eggsacc/FOCdrive/Kicad/FOC-driver.kicad_pcb

## KiCad design Kicad/FOC-driver.kicad_pcb (2026-07-19)

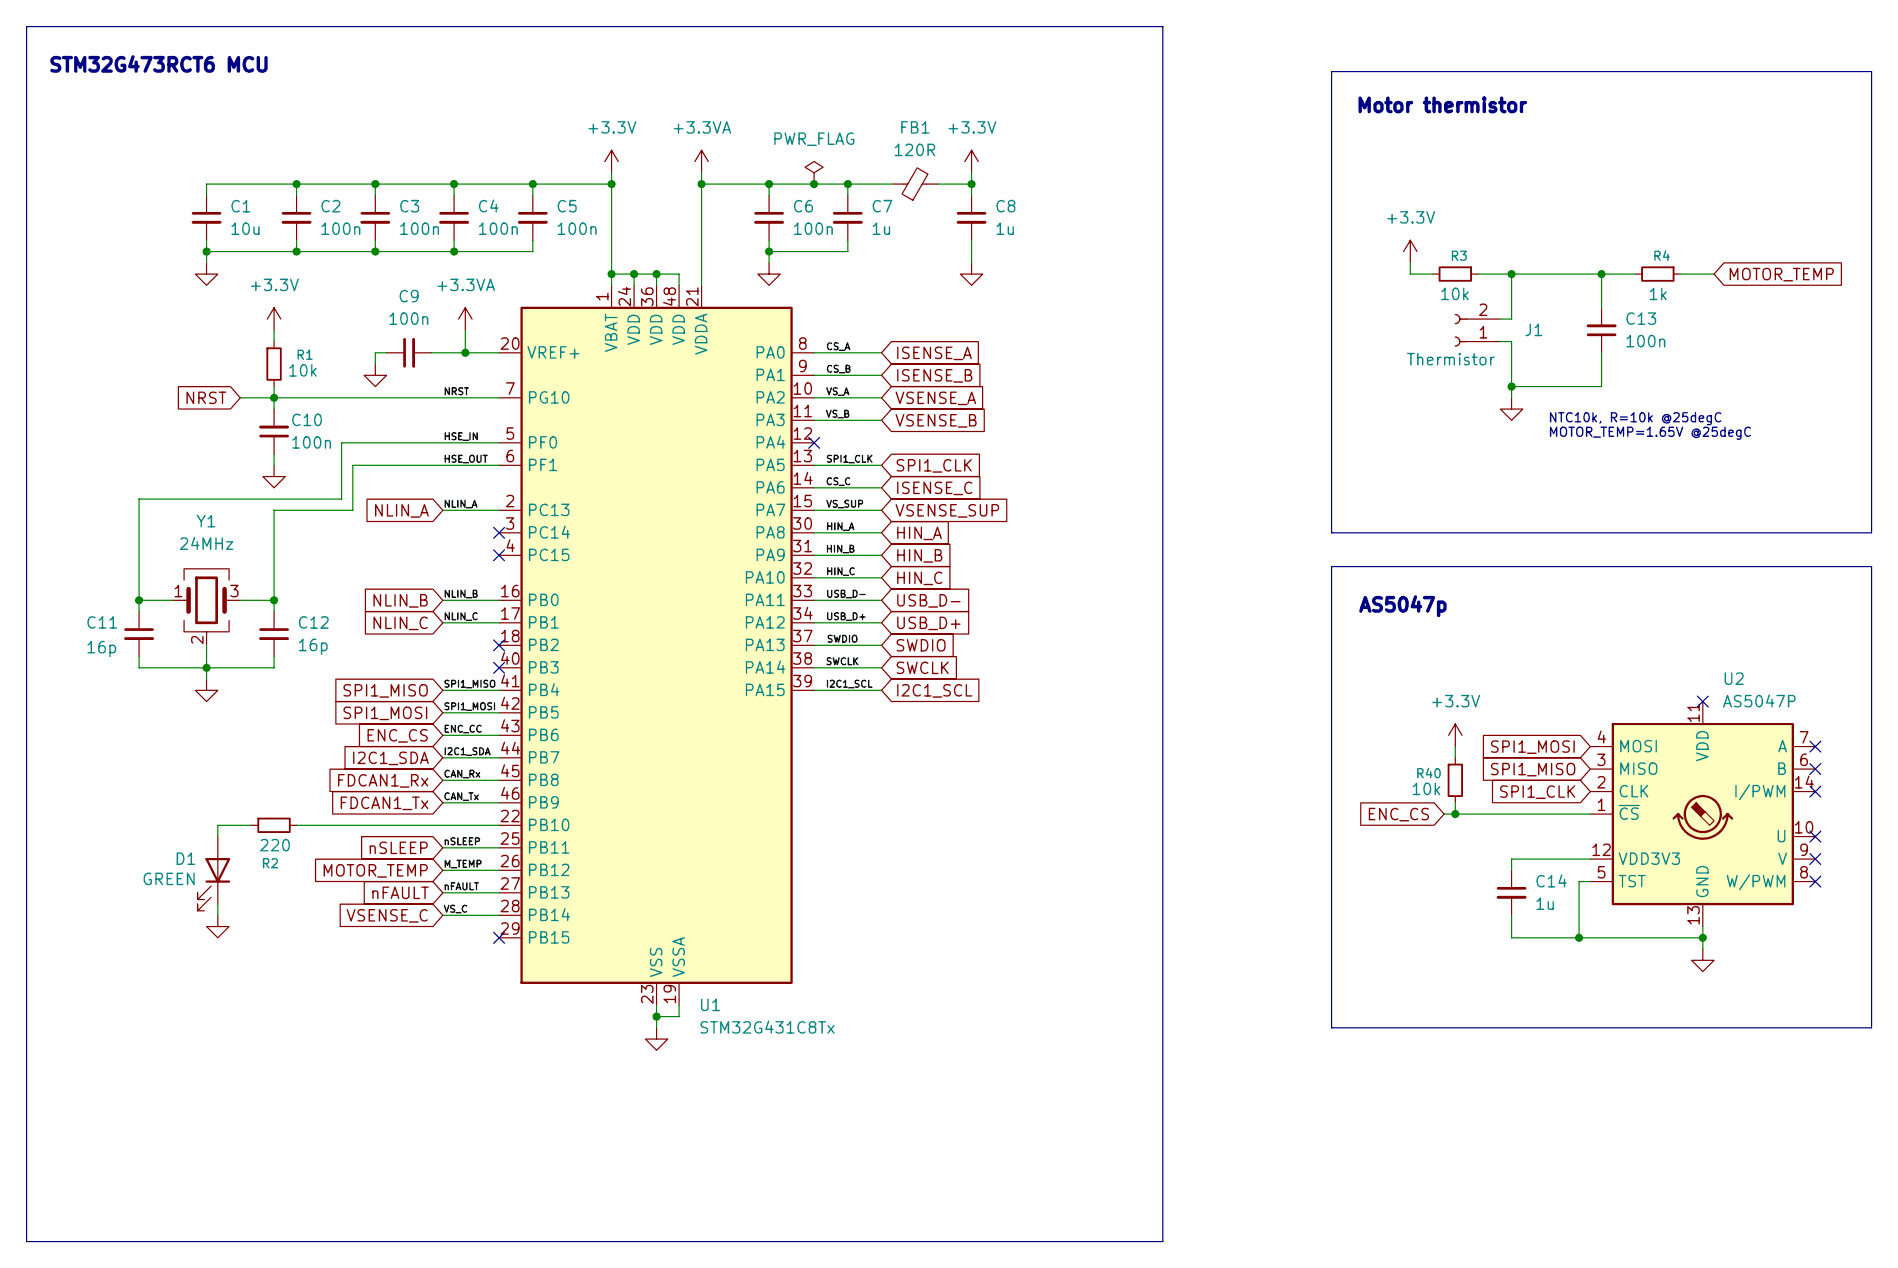
[picture p5: schematic untitled.kicad_sch]

Parts:
C1: 10u; C_1206_3216Metric
C2, C3, C4, C5, C6, C9, C13: 100n; C_0402_1005Metric
C7, C8, C14: 1u; C_0603_1608Metric
C10: 100n; C_01005_0402Metric
C11, C12: 16p; C_0402_1005Metric
D1: GREEN; LED_0603_1608Metric
FB1: 120R; L_0603_1608Metric
J1: Thermistor; 2p SolderWire Pad
R1, R3, R40: 10k; R_0402_1005Metric
R2: 220; R_0603_1608Metric
R4: 1k; R_0402_1005Metric
U1: STM32G431C8Tx; LQFP-48_7x7mm_P0.5mm
U2: AS5047P; TSSOP-14_4.4x5mm_P0.65mm
Y1: 24MHz; Crystal_SMD_3225-4Pin_3.2x2.5mm

Connections:
+3.3V: C1.1, C2.1, C3.1, C4.1, C5.1, C8.1, FB1.2, R1.1, R3.2, R40.1, U1.1 (VBAT), U1.24 (VDD), U1.36 (VDD), U1.48 (VDD); also elsewhere on the board
+3.3VA: C6.1, C7.1, C9.2, FB1.1, U1.20 (VREF+), U1.21 (VDDA); also elsewhere on the board
/mcu/HSE_IN: C11.1, U1.5 (PF0), Y1.1
/mcu/HSE_OUT: C12.1, U1.6 (PF1), Y1.3
ENC_CS: R40.2, U1.43 (PB6), U2.1 (~CS)
FDCAN1_Rx: U1.45 (PB8); also elsewhere on the board
FDCAN1_Tx: U1.46 (PB9); also elsewhere on the board
HIN_A: U1.30 (PA8); also elsewhere on the board
HIN_B: U1.31 (PA9); also elsewhere on the board
HIN_C: U1.32 (PA10); also elsewhere on the board
I2C1_SCL: U1.39 (PA15); also elsewhere on the board
I2C1_SDA: U1.44 (PB7); also elsewhere on the board
ISENSE_A: U1.8 (PA0); also elsewhere on the board
ISENSE_B: U1.9 (PA1); also elsewhere on the board
ISENSE_C: U1.14 (PA6); also elsewhere on the board
LSS: C1.2, C2.2, C3.2, C4.2, C5.2, C6.2, C7.2, C8.2, C9.1, C10.1, C11.2, C12.2, C13.1, C14.2, D1.1 (K), J1.1, U1.19 (VSSA), U1.23 (VSS), U1.35 (VSS), U1.47 (VSS), U2.5 (TST), U2.13 (GND), Y1.2 (G), Y1.4 (G); also elsewhere on the board
MOTOR_TEMP: R4.1, U1.26 (PB12)
NLIN_A: U1.2 (PC13); also elsewhere on the board
NLIN_B: U1.16 (PB0); also elsewhere on the board
NLIN_C: U1.17 (PB1); also elsewhere on the board
NRST: C10.2, R1.2, U1.7 (PG10); also elsewhere on the board
unnamed: D1.2 (A), R2.1
unnamed: C13.2, J1.2, R3.1, R4.2
unnamed: R2.2, U1.22 (PB10)
unnamed: C14.1, U2.12 (VDD3V3)
SPI1_CLK: U1.13 (PA5), U2.2 (CLK)
SPI1_MISO: U1.41 (PB4), U2.3 (MISO)
SPI1_MOSI: U1.42 (PB5), U2.4 (MOSI)
SWCLK: U1.38 (PA14); also elsewhere on the board
SWDIO: U1.37 (PA13); also elsewhere on the board
USB_D+: U1.34 (PA12); also elsewhere on the board
USB_D-: U1.33 (PA11); also elsewhere on the board
VSENSE_A: U1.10 (PA2); also elsewhere on the board
VSENSE_B: U1.11 (PA3); also elsewhere on the board
VSENSE_C: U1.28 (PB14); also elsewhere on the board
VSENSE_SUP: U1.15 (PA7); also elsewhere on the board
nFAULT: U1.27 (PB13); also elsewhere on the board
nSLEEP: U1.25 (PB11); also elsewhere on the board

Notes on the sheet:
AS5047p
STM32G473RCT6 MCU
NTC10k, R=10k @25degC MOTOR_TEMP=1.65V @25degC
Motor thermistor

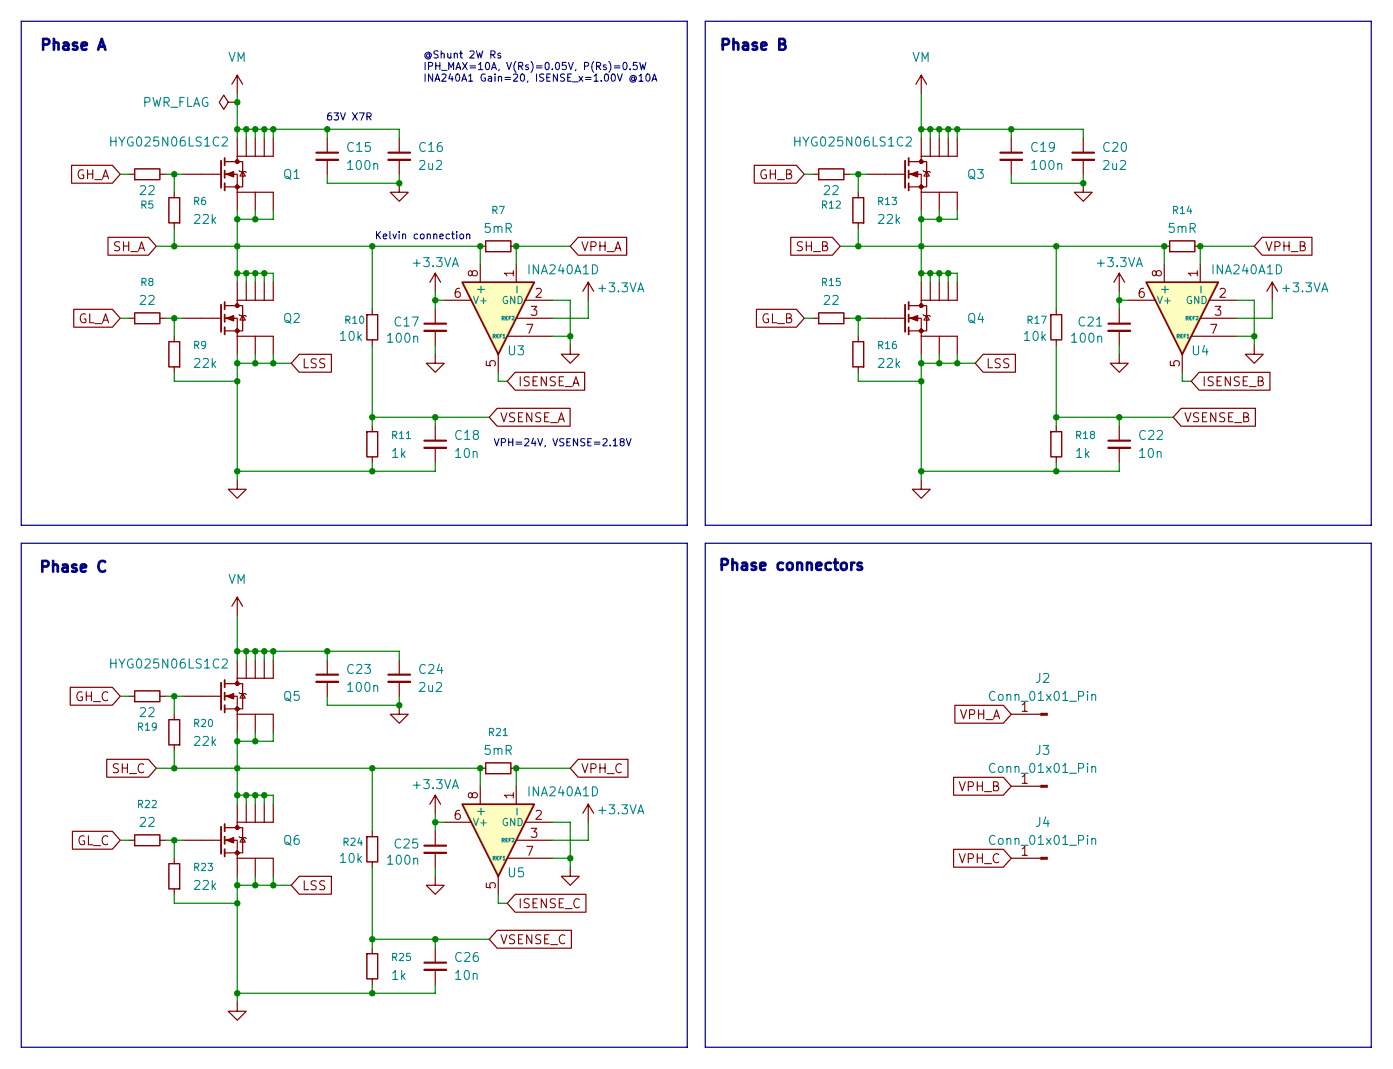
[picture p6: schematic half-bridges.kicad_sch]

Parts:
C15, C17, C19, C21, C23, C25: 100n; C_0603_1608Metric
C16, C20, C24: 2u2; C_1206_3216Metric
C18, C22, C26: 10n; C_0402_1005Metric
J2, J3, J4: Conn_01x01_Pin; WireSolder-ID1.6mm-OD3mm
Q1, Q2, Q3, Q4, Q5, Q6: HYG025N06LS1C2
R5, R8, R12, R15, R19, R22: 22; R_0603_1608Metric
R6, R9, R13, R16, R20, R23: 22k; R_0603_1608Metric
R7, R14, R21: 5mR; R_2512_6332Metric
R10, R17, R24: 10k; R_0402_1005Metric
R11, R18, R25: 1k; R_0402_1005Metric
U3, U4, U5: INA240A1D; SOIC-8_3.9x4.9mm_P1.27mm

Connections:
+3.3VA: C17.1, C21.1, C25.1, U3.3 (REF2), U3.6 (V+), U4.3 (REF2), U4.6 (V+), U5.3 (REF2), U5.6 (V+); also elsewhere on the board
GH_A: R5.1; also elsewhere on the board
GH_B: R12.1; also elsewhere on the board
GH_C: R19.1; also elsewhere on the board
GL_A: R8.1; also elsewhere on the board
GL_B: R15.1; also elsewhere on the board
GL_C: R22.1; also elsewhere on the board
ISENSE_A: U3.5; also elsewhere on the board
ISENSE_B: U4.5; also elsewhere on the board
ISENSE_C: U5.5; also elsewhere on the board
LSS: C15.2, C16.2, C17.2, C18.2, C19.2, C20.2, C21.2, C22.2, C23.2, C24.2, C25.2, C26.2, Q2.1 (S), Q2.2 (S), Q2.3 (S), Q4.1 (S), Q4.2 (S), Q4.3 (S), Q6.1 (S), Q6.2 (S), Q6.3 (S), R9.1, R11.2, R16.1, R18.2, R23.1, R25.2, U3.2 (GND), U3.4 (GND), U3.7 (REF1), U4.2 (GND), U4.4 (GND), U4.7 (REF1), U5.2 (GND), U5.4 (GND), U5.7 (REF1); also elsewhere on the board
unnamed: Q1.4 (G), R5.2, R6.2
unnamed: Q2.4 (G), R8.2, R9.2
unnamed: Q3.4 (G), R12.2, R13.2
unnamed: Q4.4 (G), R15.2, R16.2
unnamed: Q5.4 (G), R19.2, R20.2
unnamed: Q6.4 (G), R22.2, R23.2
PVDD: C15.1, C16.1, C19.1, C20.1, C23.1, C24.1, Q1.5 (D), Q1.6, Q1.7, Q1.8, Q1.9, Q3.5 (D), Q3.6, Q3.7, Q3.8, Q3.9, Q5.5 (D), Q5.6, Q5.7, Q5.8, Q5.9; also elsewhere on the board
SH_A: Q1.1 (S), Q1.2 (S), Q1.3 (S), Q2.5 (D), Q2.6, Q2.7, Q2.8, Q2.9, R6.1, R7.1, R10.1, U3.8 (+); also elsewhere on the board
SH_B: Q3.1 (S), Q3.2 (S), Q3.3 (S), Q4.5 (D), Q4.6, Q4.7, Q4.8, Q4.9, R13.1, R14.1, R17.1, U4.8 (+); also elsewhere on the board
SH_C: Q5.1 (S), Q5.2 (S), Q5.3 (S), Q6.5 (D), Q6.6, Q6.7, Q6.8, Q6.9, R20.1, R21.1, R24.1, U5.8 (+); also elsewhere on the board
VPH_A: J2.1 (Pin_1_1), R7.2, U3.1 (-)
VPH_B: J3.1 (Pin_1_1), R14.2, U4.1 (-)
VPH_C: J4.1 (Pin_1_1), R21.2, U5.1 (-)
VSENSE_A: C18.1, R10.2, R11.1; also elsewhere on the board
VSENSE_B: C22.1, R17.2, R18.1; also elsewhere on the board
VSENSE_C: C26.1, R24.2, R25.1; also elsewhere on the board

Notes on the sheet:
Phase A
VPH=24V, VSENSE=2.18V
@Shunt 2W Rs IPH_MAX=10A, V(Rs)=0.05V, P(Rs)=0.5W INA240A1 Gain=20, ISENSE_x=1.00V @10A
Phase B
63V X7R
Phase connectors
Phase C
Kelvin connection

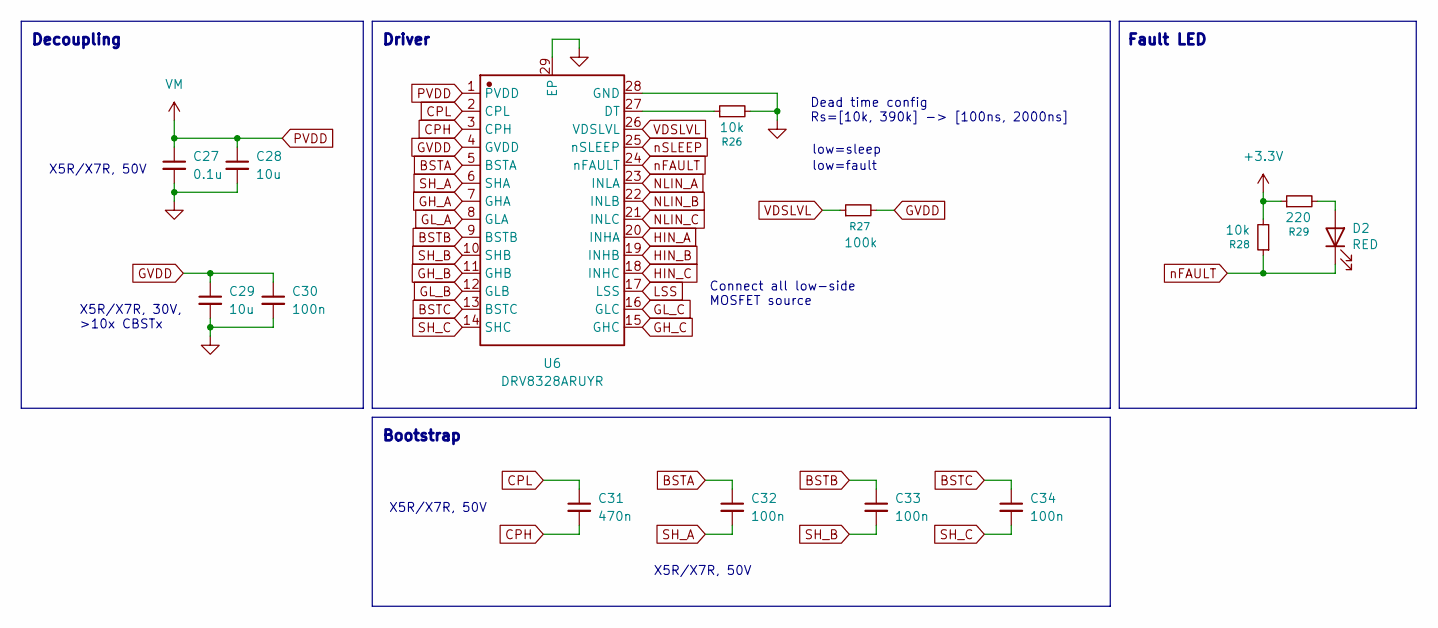
[picture p7: schematic driver.kicad_sch]

Parts:
C27: 0.1u; C_0603_1608Metric
C28, C29: 10u; C_1206_3216Metric
C30: 100n; C_0402_1005Metric
C31: 470n; C_0805_2012Metric
C32, C33, C34: 100n; C_0805_2012Metric
D2: RED; LED_0603_1608Metric
R26, R28: 10k; R_0402_1005Metric
R27: 100k; R_0402_1005Metric
R29: 220; R_0603_1608Metric
U6: DRV8328ARUYR; QFN-28_L4.0-W4.0-P0.40-BL-EP2.6 DRV8328; Manufacturer Part DRV8328BRUYR

Connections:
+3.3V: R28.2, R29.1; also elsewhere on the board
BSTA: C32.1, U6.5 (BSTA)
BSTB: C33.1, U6.9 (BSTB)
BSTC: C34.1, U6.13 (BSTC)
CPH: C31.2, U6.3 (CPH)
CPL: C31.1, U6.2 (CPL)
GH_A: U6.7 (GHA); also elsewhere on the board
GH_B: U6.11 (GHB); also elsewhere on the board
GH_C: U6.15 (GHC); also elsewhere on the board
GL_A: U6.8 (GLA); also elsewhere on the board
GL_B: U6.12 (GLB); also elsewhere on the board
GL_C: U6.16 (GLC); also elsewhere on the board
GVDD: C29.1, C30.1, R27.2, U6.4 (GVDD)
HIN_A: U6.20 (INHA); also elsewhere on the board
HIN_B: U6.19 (INHB); also elsewhere on the board
HIN_C: U6.18 (INHC); also elsewhere on the board
LSS: C27.2, C28.2, C29.2, C30.2, R26.2, U6.17 (LSS), U6.28 (GND), U6.29 (EP); also elsewhere on the board
NLIN_A: U6.23 (INLA); also elsewhere on the board
NLIN_B: U6.22 (INLB); also elsewhere on the board
NLIN_C: U6.21 (INLC); also elsewhere on the board
unnamed: D2.2 (A), R29.2
unnamed: R26.1, U6.27 (DT)
PVDD: C27.1, C28.1, U6.1 (PVDD); also elsewhere on the board
SH_A: C32.2, U6.6 (SHA); also elsewhere on the board
SH_B: C33.2, U6.10 (SHB); also elsewhere on the board
SH_C: C34.2, U6.14 (SHC); also elsewhere on the board
VDSLVL: R27.1, U6.26 (VDSLVL)
nFAULT: D2.1 (K), R28.1, U6.24 (nFAULT); also elsewhere on the board
nSLEEP: U6.25 (nSLEEP); also elsewhere on the board

Notes on the sheet:
Bootstrap
Fault LED
Connect all low-side MOSFET source
Driver
X5R/X7R, 50V
Decoupling
low=sleep
low=fault
X5R/X7R, 30V, >10x CBSTx
Dead time config Rs=[10k, 390k] -> [100ns, 2000ns]

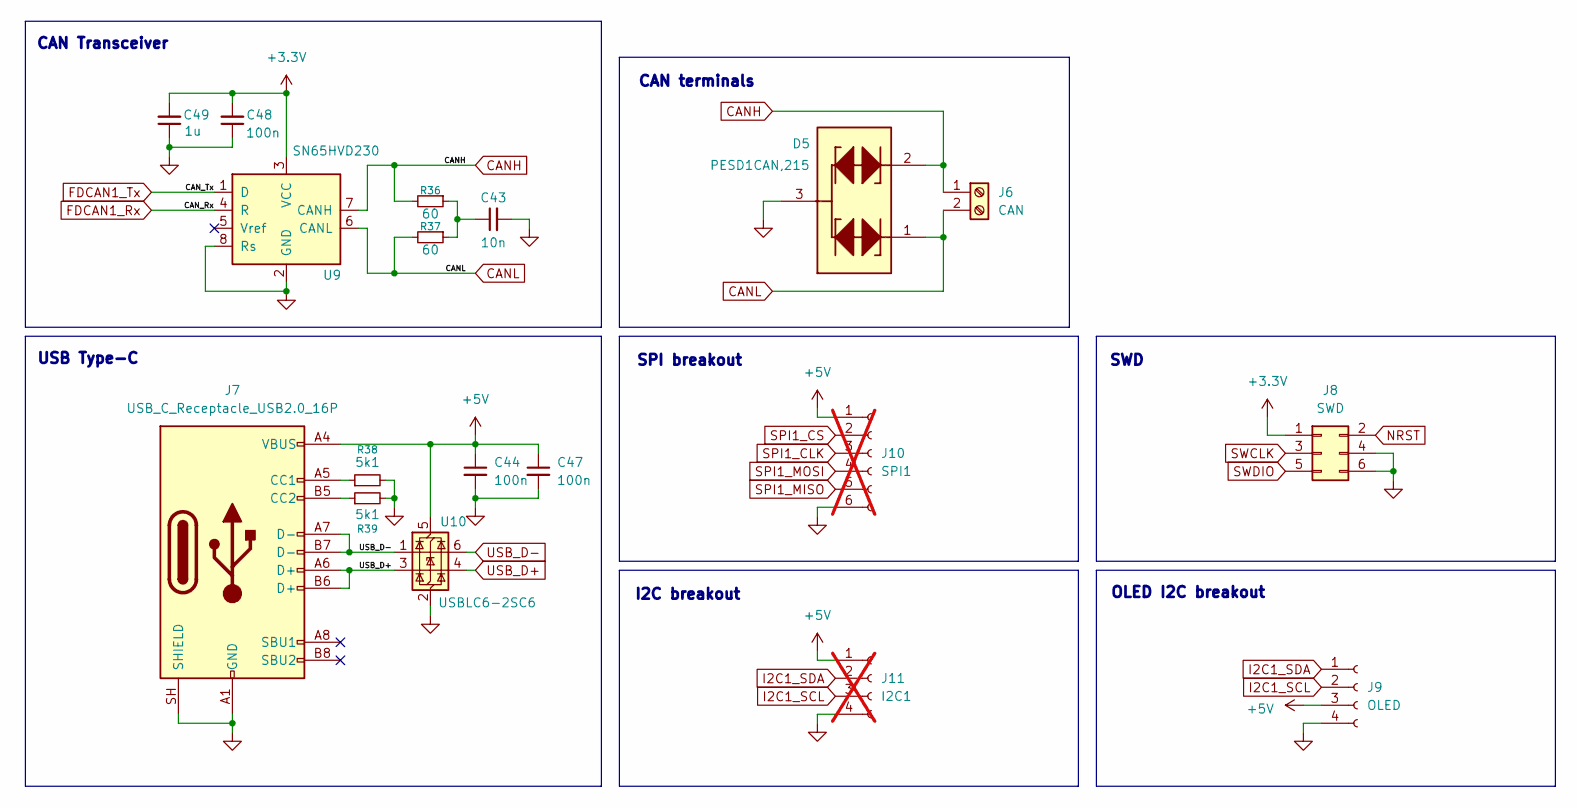
[picture p8: schematic comms.kicad_sch]

Parts:
C43: 10n; C_0402_1005Metric
C44, C47, C48: 100n; C_0402_1005Metric
C49: 1u; C_0402_1005Metric
D5: PESD1CAN,215; PESD1CAN; Manufacturer Part PESD1CAN,215
J6: CAN; TerminalBlock_Xinya_XY308-2.54-2P_1x02_P2.54mm_Horizontal
J7: USB_C_Receptacle_USB2.0_16P; USB_C_Receptacle_GCT_USB4105-xx-A_16P_TopMnt_Horizontal
J8: SWD; PinSocket_2x03_P1.27mm_Vertical
J9: OLED; PinSocket_1x04_P2.54mm_Vertical
J10: SPI1; JST_ZE_S06B-ZESK-2D_1x06_P1.50mm_Horizontal; not fitted
J11: I2C1; JST_ZE_S04B-ZESK-2D_1x04_P1.50mm_Horizontal; not fitted
R36, R37: 60; R_0603_1608Metric
R38, R39: 5k1; R_0402_1005Metric
U9: SN65HVD230; SOIC-8_3.9x4.9mm_P1.27mm
U10: USBLC6-2SC6; SOT-23-6

Connections:
+3.3V: C48.2, C49.2, J8.1, U9.3 (VCC); also elsewhere on the board
+5V: C44.1, C47.1, J7.A4 (VBUS), J7.A9 (VBUS), J7.B4 (VBUS), J7.B9 (VBUS), J9.3, J10.1, J11.1, U10.5 (VBUS); also elsewhere on the board
CANH: D5.2, J6.1, R36.2, U9.7 (CANH)
CANL: D5.1, J6.2, R37.2, U9.6 (CANL)
FDCAN1_Rx: U9.4 (R); also elsewhere on the board
FDCAN1_Tx: U9.1 (D); also elsewhere on the board
I2C1_SCL: J9.2, J11.3; also elsewhere on the board
I2C1_SDA: J9.1, J11.2; also elsewhere on the board
LSS: C43.2, C44.2, C47.2, C48.1, C49.1, D5.3, J7.A1 (GND), J7.A12 (GND), J7.B1 (GND), J7.B12 (GND), J7.SH (SHIELD), J8.4, J8.6, J9.4, J10.6, J11.4, R38.2, R39.2, U9.2 (GND), U9.8 (Rs), U10.2 (GND); also elsewhere on the board
NRST: J8.2; also elsewhere on the board
unnamed: C43.1, R36.1, R37.1
unnamed: J7.A5 (CC1), R38.1
unnamed: J7.B5 (CC2), R39.1
SWCLK: J8.3; also elsewhere on the board
SWDIO: J8.5; also elsewhere on the board
USB_D+: J7.A6 (D+), J7.B6 (D+), U10.3 (I/O2), U10.4 (I/O2); also elsewhere on the board
USB_D-: J7.A7 (D-), J7.B7 (D-), U10.1 (I/O1), U10.6 (I/O1); also elsewhere on the board

Notes on the sheet:
OLED I2C breakout
SWD
CAN Transceiver
USB Type-C
SPI breakout
I2C breakout
CAN terminals

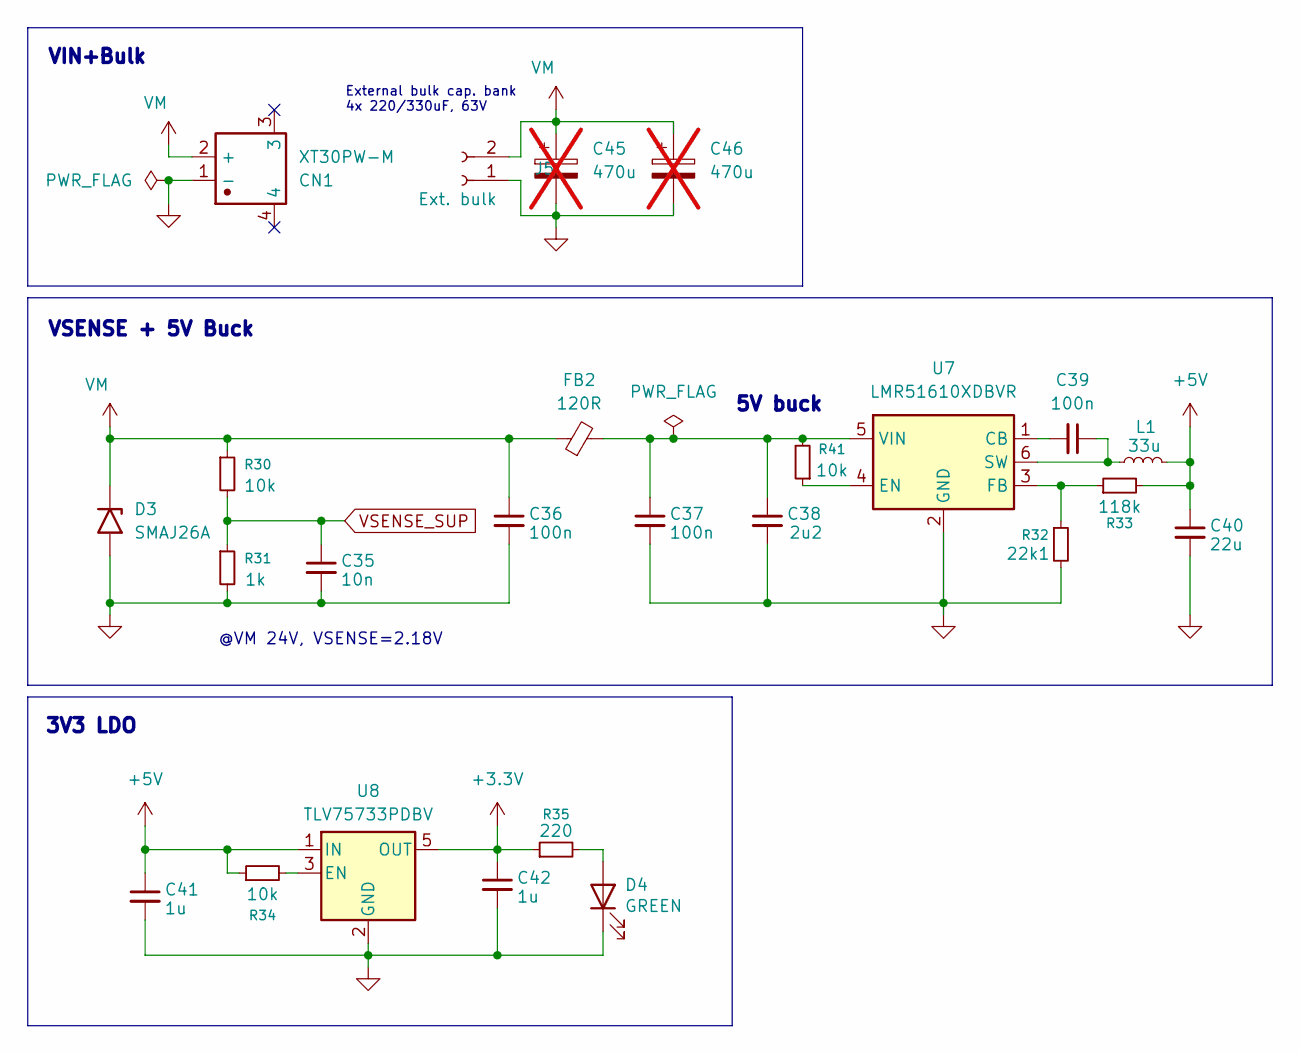
[picture p9: schematic power.kicad_sch]

Parts:
C35: 10n; C_0402_1005Metric
C36, C37, C39: 100n; C_0402_1005Metric
C38: 2u2; C_0805_2012Metric
C40: 22u; C_1206_3216Metric
C41, C42: 1u; C_0603_1608Metric
C45, C46: 470u; CP_Elec_10x12.5; not fitted
CN1: XT30PW-M; CONN-TH_XT30PW-M; Manufacturer Part XT60PW-M
D3: SMAJ26A; D_SMA
D4: GREEN; LED_0603_1608Metric
FB2: 120R; L_0603_1608Metric
J5: Ext. bulk; 2p WireSolder 1.3mmID_2mmOD
L1: 33u; L_10.4x10.4_H4.8
R30, R34, R41: 10k; R_0402_1005Metric
R31: 1k; R_0402_1005Metric
R32: 22k1; R_0402_1005Metric
R33: 118k; R_0402_1005Metric
R35: 220; R_0603_1608Metric
U7: LMR51610XDBVR; SOT-23-6
U8: TLV75733PDBV; SOT-23-5

Connections:
+3.3V: C42.1, R35.1, U8.5 (OUT); also elsewhere on the board
+5V: C40.1, C41.1, L1.2, R33.2, R34.1, U8.1 (IN); also elsewhere on the board
LSS: C35.2, C36.2, C37.2, C38.2, C40.2, C41.2, C42.2, C45.2, C46.2, CN1.1 (-), D3.2 (A2), D4.1 (K), J5.1, R31.2, R32.2, U7.2 (GND), U8.2 (GND); also elsewhere on the board
unnamed: D4.2 (A), R35.2
unnamed: C39.2, U7.1 (CB)
unnamed: R41.1, U7.4 (EN)
unnamed: R32.1, R33.1, U7.3 (FB)
unnamed: C39.1, L1.1, U7.6 (SW)
unnamed: C37.1, C38.1, FB2.2, R41.2, U7.5 (VIN)
unnamed: R34.2, U8.3 (EN)
PVDD: C36.1, C45.1, C46.1, CN1.2 (+), D3.1 (A1), FB2.1, J5.2, R30.1; also elsewhere on the board
VSENSE_SUP: C35.1, R30.2, R31.1; also elsewhere on the board

Notes on the sheet:
External bulk cap. bank 4x 220/330uF, 63V
VIN+Bulk
@VM 24V, VSENSE=2.18V
5V buck
3V3 LDO
VSENSE + 5V Buck

Board: 4 copper layers, 123 parts (6 on the bottom side), 79 nets, no tracks yet.
