eggsacc/FOCdrive/STM32G431CBTx-config/STM32G431CBTx-config.ioc

Mcu.UserName=STM32G431CBTx
PA0.GPIO_Label=ISENSE_A
PA0.Signal=ADC1_IN1
PA1.GPIO_Label=ISENSE_B
PA1.Signal=ADC1_IN2
PA10.Signal=S_TIM1_CH3
PA11.Signal=USB_DM
PA12.Signal=USB_DP
PA13.Signal=SYS_JTMS-SWDIO
PA14.Signal=SYS_JTCK-SWCLK
PA15.Signal=I2C1_SCL
PA2.GPIO_Label=VSENSE_A
PA2.Signal=ADC1_IN3
PA3.GPIO_Label=VSENSE_B
PA3.Signal=ADC1_IN4
PA5.Signal=SPI1_SCK
PA6.GPIO_Label=ISENSE_C
PA6.Signal=ADC2_IN3
PA7.GPIO_Label=VSENSE_SUP
PA7.Signal=ADC2_IN4
PA8.Signal=S_TIM1_CH1
PA9.Signal=S_TIM1_CH2
PB0.Signal=TIM1_CH2N
PB1.Signal=TIM1_CH3N
PB10.GPIO_Label=STATUS_LED
PB10.Signal=GPIO_Output
PB11.Signal=GPIO_Output
PB12.GPIO_Label=MOTOR_TEMP
PB12.Signal=ADC1_IN11
PB13.GPIO_Label=nFAULT
PB13.Signal=GPIO_Input
PB14.GPIO_Label=VSENSE_C
PB14.Signal=ADC1_IN5
PB4.Signal=SPI1_MISO
PB5.Signal=SPI1_MOSI
PB6.GPIO_Label=ENC_CS
PB6.Signal=GPIO_Output
PB7.Signal=I2C1_SDA
PB8-BOOT0.Signal=FDCAN1_RX
PB9.Signal=FDCAN1_TX
PC13.Signal=TIM1_CH1N
PF0-OSC_IN.Signal=RCC_OSC_IN
PF1-OSC_OUT.Signal=RCC_OSC_OUT
