eggsacc/FOCdrive/(commit log)

2026-07-13 moved files into folder
    [FOC-driver.kicad_pcb, FOC-driver.kicad_sch, comms.kicad_sch, driver.kicad_sch, half-bridges.kicad_sch, mcu.kicad_sch, power.kicad_sch, untitled.kicad_sch]
2026-07-14 hw(stm32): changed MCU to STM32G431CBTx since opamps unused.
    [FOC-driver.kicad_pcb, untitled.kicad_sch]
2026-07-15 hw(pcb-sch): rename component ref & pcb manufacturing capability
    [half-bridges.kicad_sch, power.kicad_sch, untitled.kicad_sch]
2026-07-15 hw(pcb): initial grouping + layout guidlines
    [FOC-driver.kicad_pcb, comms.kicad_sch, driver.kicad_sch, half-bridges.kicad_sch, power.kicad_sch, untitled.kicad_sch]
